abrilcode/neoapnea-monitor/(commit log)

2026-10-12 Add the Arduino firmware
    Reads chest motion from an MPU-6050 (z axis) and the pulse wave from a
    MAX30102 on one I2C bus, and streams both over USB serial at 57600 baud:
    a Buffer frame every 0.25 s and an SpO2 line after every 100 PPG samples.
2026-10-12 Add the browser monitor
    A static site with no build step: live chest and pulse waveforms, heart
    rate, SpO2 and breathing rate, three alarms with optional sound, a trend
    of the last 30 min to 24 h, per-patient records in localStorage with CSV
    and JSON export. Runs on the built-in simulator or reads the Arduino over
    Web Serial. scripts/serve.mjs serves it on localhost.
